Muzoka/Robot-Fable/docs/images/map-3pt.png

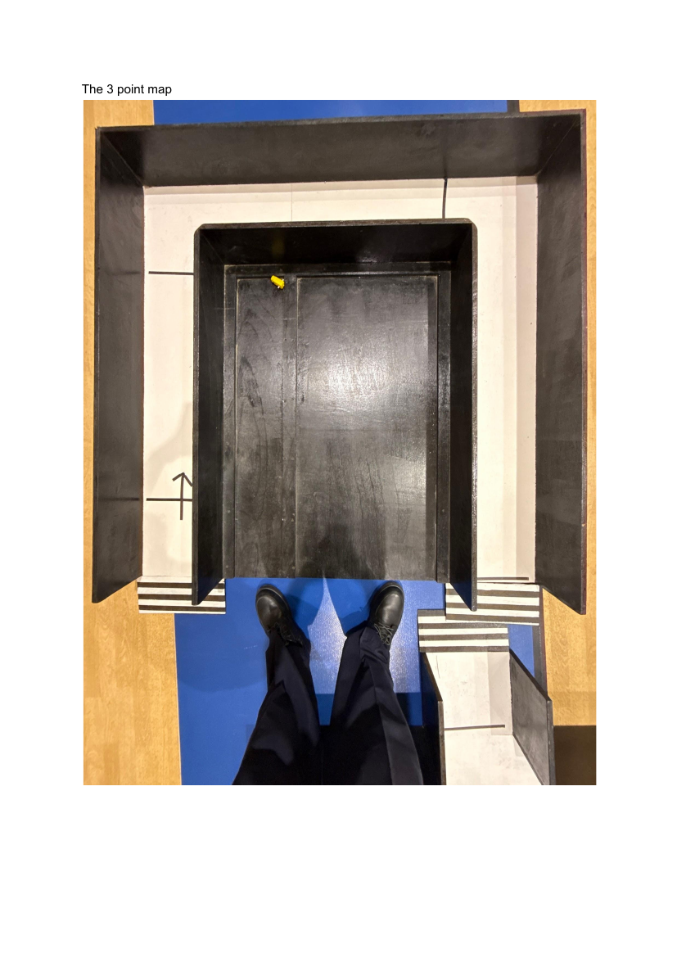
docs/images/map-3pt.png
