Muzoka/Robot-Fable/docs/images/map-9pt.png

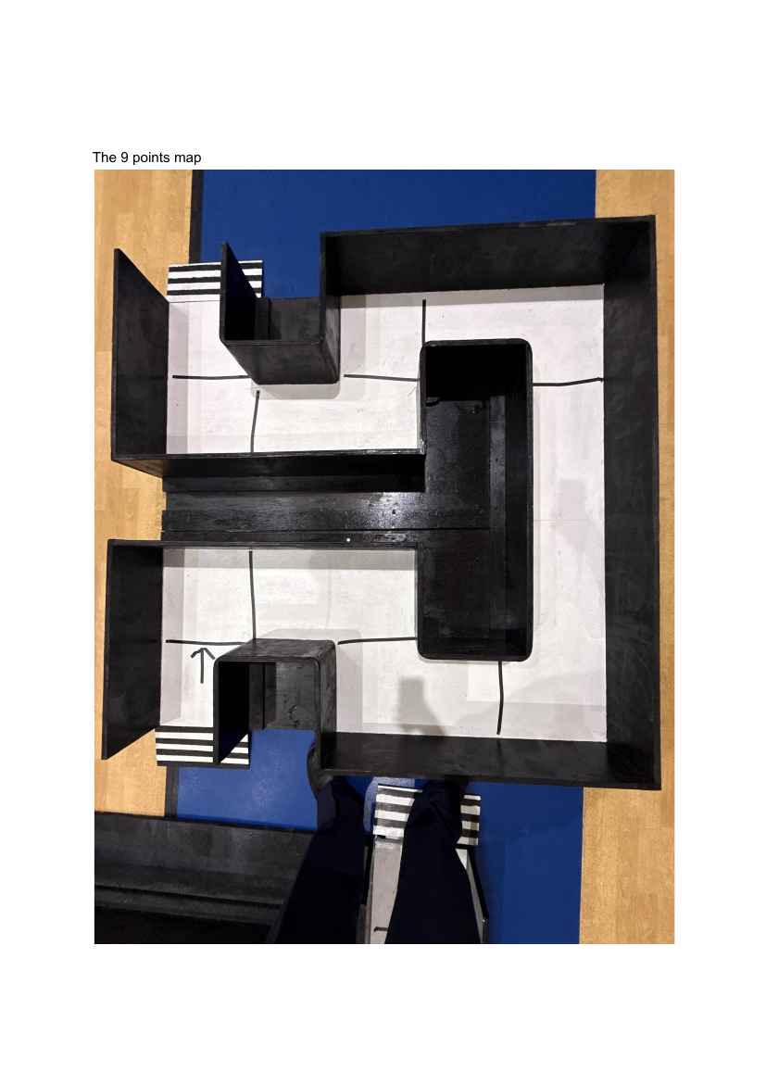
docs/images/map-9pt.png
