Muzoka/Robot-Fable/docs/images/map-5pt.png

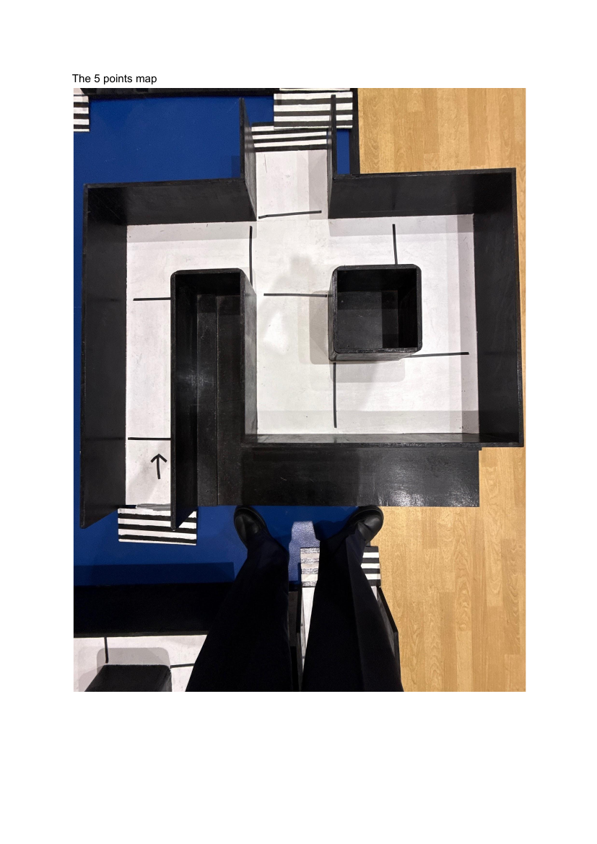
docs/images/map-5pt.png
