Muzoka/Robot-Fable/sim/traces/map1-seed3.png

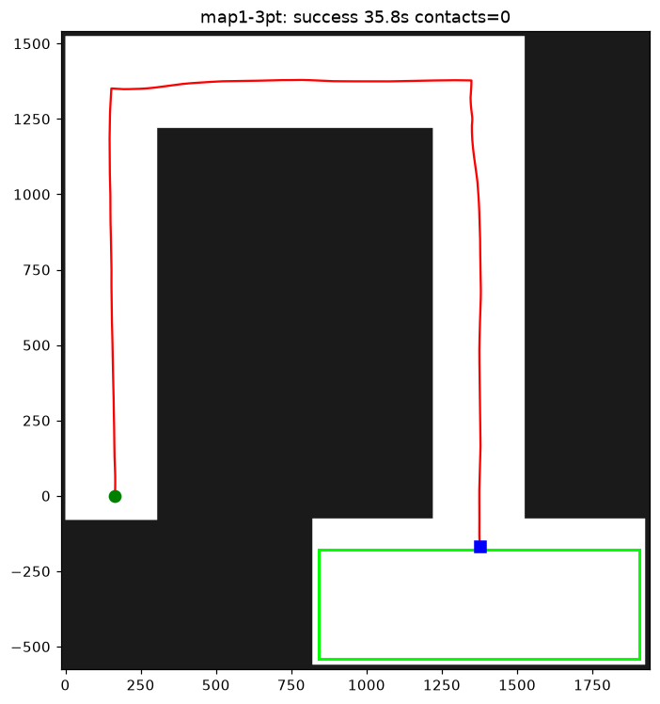
sim/traces/map1-seed3.png
