Muzoka/Robot-Fable/sim/traces/map2-seed3.png

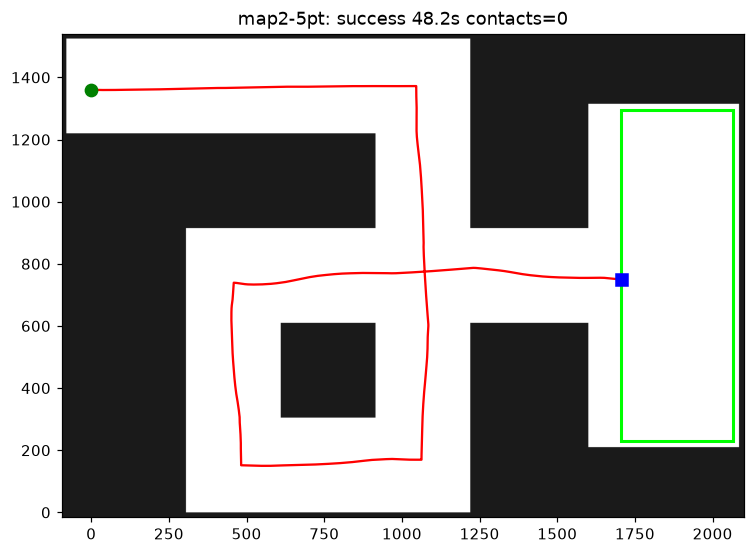
sim/traces/map2-seed3.png
