Muzoka/Robot-Fable/sim/traces/map3-seed3.png

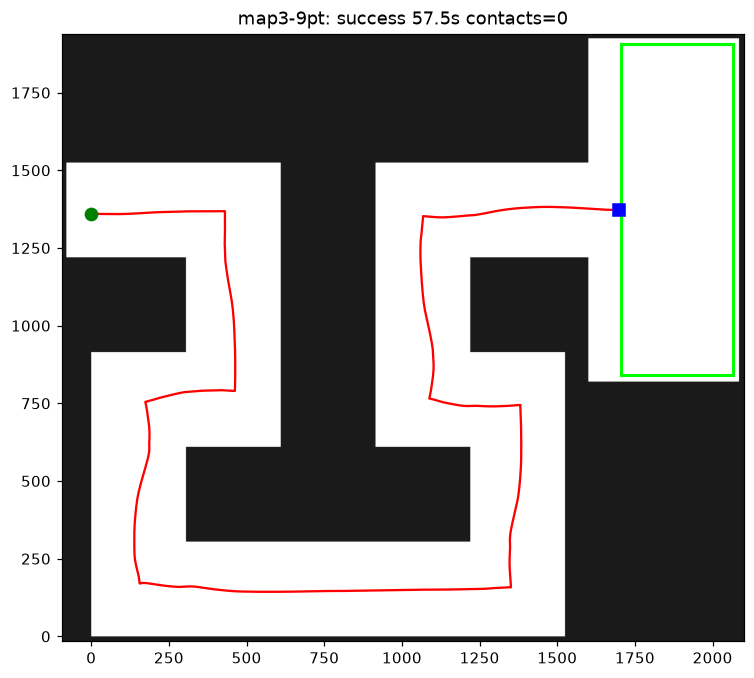
sim/traces/map3-seed3.png
