Muzoka/Robot-Fable/(commit log)

2026-08-19 Phase 0: analysis, hardware audit, verified research, and master plan
    - README + master plan (docs/PLAN.md): hybrid scripted+reactive strategy,
    phase breakdown, open questions for the team
    - docs/HARDWARE_AUDIT.md: D12-to-L298N-5V wire must be removed; corrected
    reading of the wiring list against the prior pin map; power policy
    - docs/IDEAS_REVIEW.md: engineering evaluation of the team's three ideas
    - docs/TRACK_NOTES.md: geometry derived from measurements, route
    hypotheses per map, finish-detection approach
    - docs/RESEARCH.md: adversarially fact-checked component facts and prior
    art, including measured lessons from Muzoka/Robotic-comp
    - docs/images: the three track photos extracted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
    [config.h, nav_core.cpp]
2026-08-19 Phase 1: track simulator, hardened controller, Monte Carlo tuning
    - sim/: 2D simulation of the robot on all three maps - motor deadband/
    lag/mismatch/battery model, HC-SR04 with verified failure modes
    (specular dropout, close-range garbage-far, cone, noise, dropout),
    firmware-identical sensor scheduling and filtering
    - controller.py: portable hybrid scripted+reactive state machine with
    ten hardening mechanisms, each earned by an observed failure (blind-
    zone rule, chaos guard, wiggle check, CROSS/SQUARE states, finish
    arming, turn reverse-retry, escalating recovery)
    - Monte Carlo results: map1 50/50, map3 nominal 25/25, overall ~94%
    completion under hostile perturbations; resid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
    [config.py, controller.py, robot.py, run.py, sensors.py, track.py]
2026-08-19 Phase 1b: rebuild maps from the organisers' spreadsheet, retune
    - docs: vendor the official 5x5-grid map drawings; confirmed layouts and
    route scripts in TRACK_NOTES (map 3 is a pure serpentine - no
    side-opening turns anywhere in the competition)
    - sim/track.py: grid-driven map builder (cell sets from the spreadsheet,
    mouth stubs, open-floor aprons, crossing-the-mouth finish condition)
    - controller: hold-heading on partial walls when a crossing is pending
    (kills the receding-wall chase that seeded crossing yaw), deeper
    blind-zone escape before pivots
    - Monte Carlo on confirmed maps: nominal 74-75/75 completion,
    degraded ~67-70/75; failures concentrated in worst-case parameter dra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
    [Robotics_Competition_Maps_v2_5x5_grid.xlsx]
2026-08-19 Phase 2: competition firmware, calibration suite, Wokwi verification
    - firmware/competition: faithful port of the tuned sim controller.
    Compile-verified (arduino:avr, 36% flash / 27% RAM with telemetry,
    29%/11% race build). Map-select jumpers on D2/D3, hand-over-sensor
    arming with start-line self-test and LED blink codes, active-brake
    motor layer with slew and deadband floor, clone echo-latch watchdog.
    - Adversarial port review vs sim/controller.py: two findings fixed
    (out-of-range echoes now classified no-echo like the sim; restored a
    brake statement swallowed into a comment).
    - firmware/calibration: 8-test serial-menu suite for the Phase-3
    on-robot session (direction, deadban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
    [calibration.ino, competition.ino]
2026-08-20 Calibration suite: short-USB-cable workflow
    - Motion tests get an 8 s unplug countdown and run on battery; robot
    stops with a slow LED blink for measuring, team replugs afterwards
    - Trim and turn-time adjustments persist in EEPROM across the serial-
    monitor reset, menu prints saved values every boot
    - Deadband test redesigned to short creep pulses so the robot stays
    beside the laptop; brake test does brake+coast in one unplugged run
    - Protocol doc updated; hardware audit marks the D12 fix done
    Claude-Session: https://claude.ai/code/session_01BfcJWwayFur7UWWtQAWNvC
    [calibration.ino]
2026-08-20 Protocol doc: match the new calibration keys
    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
2026-08-20 Protocol: battery pairing policy and results-collection workflow
    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
2026-08-20 Protocol: note on spontaneous wheel spin at power-up
    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
2026-08-20 Calibration: fix newline-abort bug found by the team in test 2
    The Serial Monitor appends a newline to every send; readKey now drains
    it and the deadband/stream abort checks only honor printable characters.
    Without this, test 2 aborted after its first pulse.
    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
    [calibration.ino]
2026-08-20 Calibration: add test 0, enable-wire check
    Full-power lunge at PWM 40 with no ENA/ENB caps fitted points at a
    floating/misrouted enable wire; test 0 drives each motor's direction
    pins with speed=0 - a wheel that spins then has an enable wire that
    is not reaching its Arduino pin.
    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
2026-08-20 calibration: extend deadband test to PWM 200 + add kick-and-hold sub-test
    First floor session showed no movement anywhere in the 40-110 ramp
    (free wheels spin at 140) - loaded static friction sits above 110.
    Test 2 is now a submenu: 'r' ramps 90-200 in 0.5 s pulses to find
    breakaway; 'k' fires a 90 ms full-power kick then holds a descending
    PWM to find the lowest sustain floor (running friction < static).
    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
2026-08-20 calibration: bake test-2 results - cruise 180 / turn 200, kick holds 190-110
    Measured on floor: breakaway RIGHT=115, LEFT=125 (healthy band).
    Kick-and-hold 150-60 found no clear sustain, so the hold range moves
    up to 190-110 with 0.8 s holds. Cruise/turn PWM raised so tests 3/4/6/8
    actually move the robot; audit doc records the measurements.
    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
2026-08-20 firmware: calibrated sensor targets from test 5
    Centred at 77 mm true per side: L reads 87.9 (sd 1.4), R 90.3 (sd 0.9),
    0 misses. Centred differential right-left = +2.4 mm, replacing the
    hand-measured ~8.5 mm. Targets re-anchored to the real track's 74 mm
    centred clearance: TARGET_L 85.0, TARGET_R 87.5, SIDE_SUM 172.5.
    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
    [competition.ino]
2026-08-20 calibration: add wiggle test (w) to hunt intermittent left-motor connection
    TRIM_R swung 0 to -13 within one session; with the earlier left-wheel
    dropout and rising left breakaway this points at a high-resistance
    intermittent joint in the left channel. New menu test runs both motors
    at cruise for 20 s (wheels free) while each left-channel wire is
    wiggled one at a time to catch the stutter live.
    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
2026-08-20 docs: session-end pivot timings (L 320 / R ~300) + fresh-charge endgame plan
    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
2026-08-20 firmware: race build with calibrated speeds, EEPROM tunables, kick-start
    - PWM constants raised to the measured floor: FLOOR 150, CRUISE 180,
    SLOW 160, TURN 200, BACK 170 (test 2: breakaway 115-140 loaded).
    - TRIM_R and TURN90 L/R now load at boot from the same EEPROM slots the
    calibration sketch writes (magic 0x5246), with plausibility windows
    and compiled fresh-charge defaults as fallback. Race-morning venue
    re-trim needs no re-upload.
    - Kick-start: 70 ms full-power pulse on every stop->straight transition
    (test 2k showed static breakaway >> rolling sustain). Pivots excluded
    so turn timing keeps calibration dynamics.
    - Turn trim pulse 70->45 ms and wiggle segments 120->60 ms, r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
2026-08-20 sim: map-agnostic AUTO mode - 149/150 across all maps, no scripts
    Universal rule set for these tracks and any chain of them: follow the
    corridor; at a blocked front turn to the side the sensors PROVE open
    (valid medium echo beats silence - walls can mirage invisible for
    seconds); wiggle-verify only on ties; drive straight through both-open
    crossings (front must be open too); only sustained truly-far space
    finishes, gated by an echo-free-front clock and a 5 s calm-after-backup
    rule. Adds pivot over-rotation unwind (outer wall must reappear after a
    corner turn), a progress watchdog for noisy-sensor wedges, and forced-
    direction memory for pocket escapes. Scripted mode unchanged (146/150).
    run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
2026-08-20 firmware: AUTO mode port + start-line self-calibrating centering targets
    Port of the sim's map-agnostic auto navigation (149/150 MC): no-jumper
    default solves any map or chain of maps. Jumpers become scripted
    fallbacks (D2=map2, D3=map3, both=map1). Adds: evidence-based corner
    decisions (valid echo beats silence, wiggle flip on ties, forced-dir
    pocket memory), pivot over-rotation unwind via the outer-wall check,
    reactive crossing entry gated on an open front, strict exit detection
    (sides truly far + front far + echo-free-front clock + 5 s calm after
    any backup + valid-close-front bounce in FINISH), and a progress
    watchdog for noisy-sensor wedges.
    Self-test change (fixes the team's blink-6 r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
    [competition.ino]
2026-08-20 firmware: apply port-review findings
    Independent review found zero logic divergences in the AUTO port; these
    are the quantitative risks it flagged:
    - kick-start now fires on forward starts only (reverse maneuvers are
    timed and were validated at plain PWM_BACK; PWM_BACK clears breakaway
    on its own, and BACKUP's steering bias survives)
    - PWM_FLOOR 150 -> 130 (anchor to the measured kick-SUSTAIN floor, not
    static breakaway; 150 collapsed inner-wheel steering authority)
    - single-wall cruise base = cruise (sim's validated relationship, was
    cruise-10)
    - wiggle segments 60 -> 80 ms (4 raw samples per check, ~29 deg sweep)
    - lastBackupMs boots as '60 s ago' so power-on is not a recent backup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
    [competition.ino]
2026-08-20 docs: rewrite calibration protocol as a standalone test reference manual
    Covers every test in the current sketch (0-9 plus the w wiggle test)
    with how-to, pass criteria, this robot's measured baselines, a
    when-to-re-run table, and the EEPROM handoff to the race firmware.
    Written to be usable without Claude in the loop.
    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
